cleanbot3000/Cleanbot3000/README.md

# Cleanbot3000
## This repository contains all documentation related to the Systems and Power sub teams.

## **Power**
The **Power** folder contains mechanical designs of the cleanbot, documentation for motors, motor drivers, power distribution, and [arduino](Power/Arduino).
