cleanbot3000/Cleanbot3000/Systems/ROS_Packages/diffdrive_arduino/README.md

# diffdrive_arduino

**Adds ROS2 Galactic and Humble support**

This node is designed to provide an interface between a `diff_drive_controller` from `ros_control` and an Arduino running firmware from `ros_arduino_bridge`.
