cleanbot3000/Cleanbot3000/Power/Cleanbot_Mech/CleanBot_Assembly/BLWRPG093S-R139.STEP

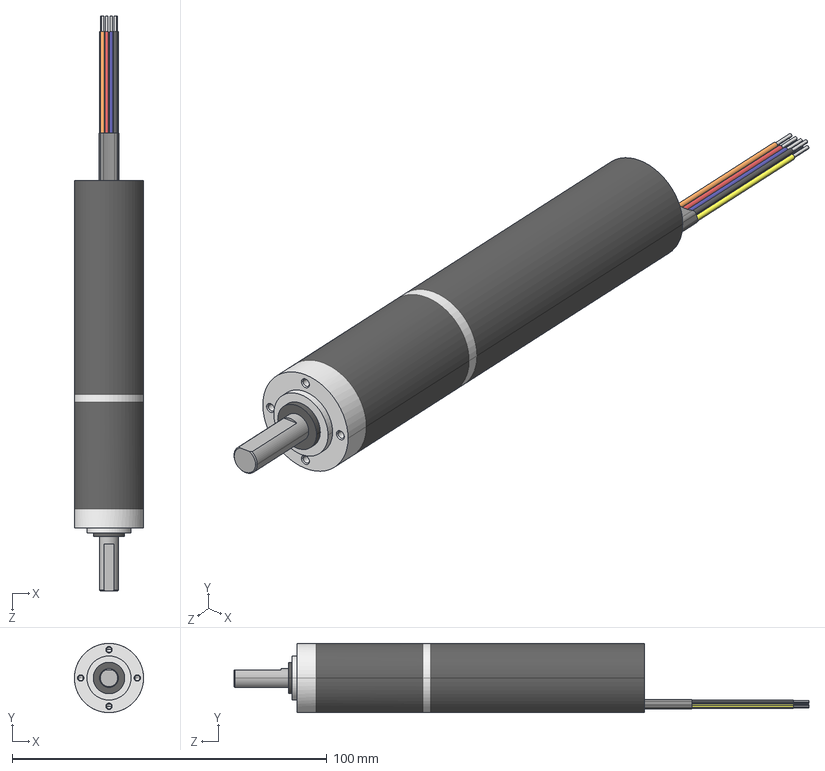
[picture p69: CAD file, 2023-09-08, last stored version]
Power/Cleanbot_Mech/CleanBot_Assembly/BLWRPG093S-R139.STEP
22.0 x 22.0 x 182.8 mm
