cleanbot3000/Cleanbot3000/Power/Cleanbot_Mech/CleanBot_Assembly/channel15.SLDPRT

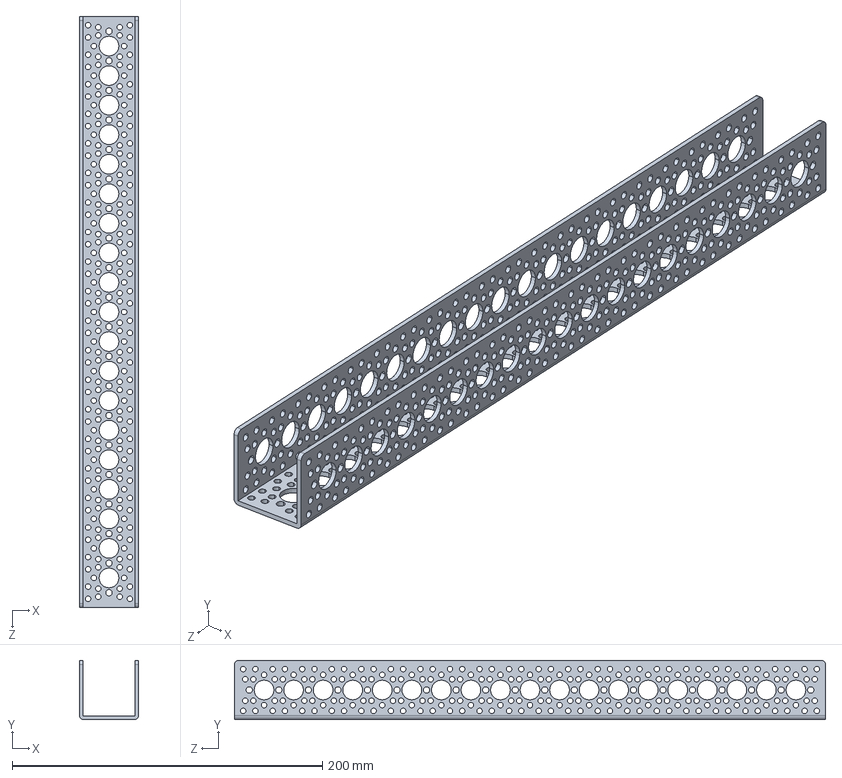
[picture p70: CAD file, 2023-09-08, last stored version]
Power/Cleanbot_Mech/CleanBot_Assembly/channel15.SLDPRT
38.1 x 38.1 x 381.0 mm
