cleanbot3000/Cleanbot3000/Power/Cleanbot_Mech/CleanBot_Assembly/LiDAR.SLDPRT

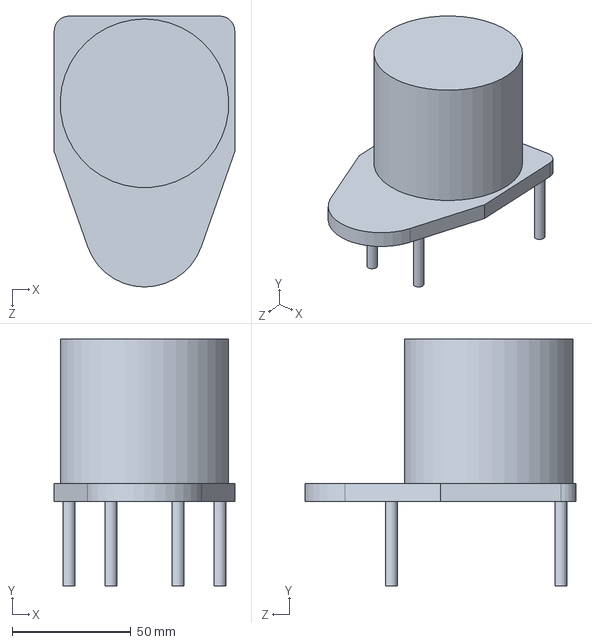
[picture p71: CAD file, 2023-09-08, last stored version]
Power/Cleanbot_Mech/CleanBot_Assembly/LiDAR.SLDPRT
76.2 x 104.1 x 114.3 mm
