cleanbot3000/Cleanbot3000/Power/Cleanbot_Mech/CleanBot_Assembly/HG-65GNB.STEP

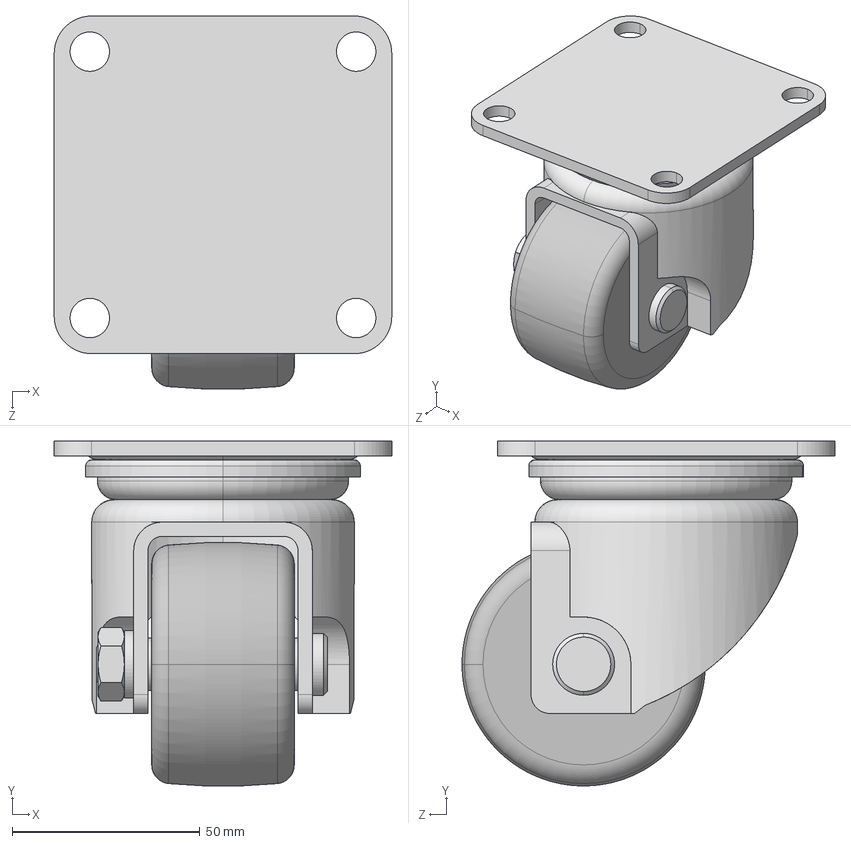
[picture p72: CAD file, 2023-09-08, last stored version]
Power/Cleanbot_Mech/CleanBot_Assembly/HG-65GNB.STEP
90.0 x 91.9 x 99.4 mm
