cleanbot3000/Cleanbot3000/Power/Cleanbot_Mech/CleanBot_Assembly/Chassis2(cover).SLDPRT

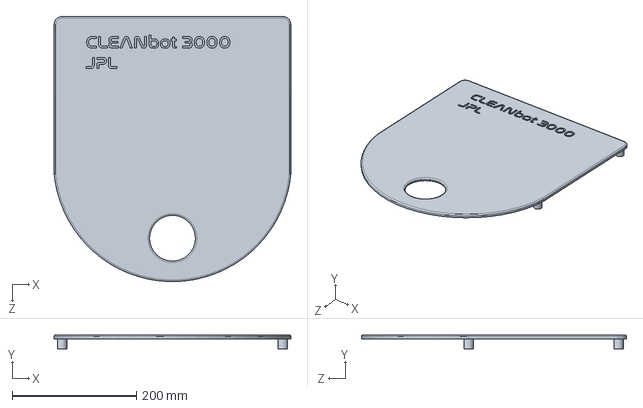
[picture p73: CAD file, 2023-09-08, last stored version]
Power/Cleanbot_Mech/CleanBot_Assembly/Chassis2(cover).SLDPRT
381.0 x 22.9 x 426.5 mm
