cleanbot3000/Cleanbot3000/Power/Cleanbot_Mech/CleanBot_Assembly/encoderHolder.SLDPRT

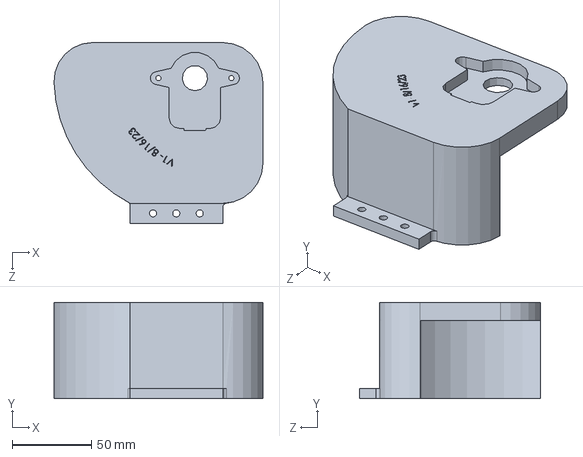
[picture p74: CAD file, 2023-09-08, last stored version]
Power/Cleanbot_Mech/CleanBot_Assembly/encoderHolder.SLDPRT
132.0 x 61.0 x 114.3 mm
