cleanbot3000/Cleanbot3000/Power/Cleanbot_Mech/CleanBot_Assembly/ENC-A5SX-XXXX-250-H-G.SLDPRT

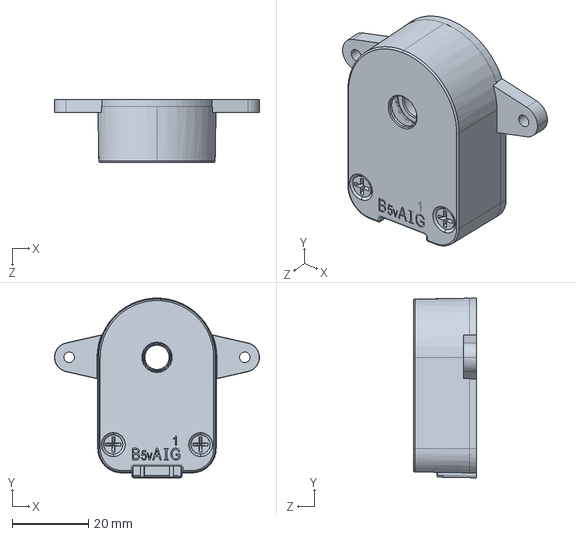
[picture p75: CAD file, 2023-09-08, last stored version]
Power/Cleanbot_Mech/CleanBot_Assembly/ENC-A5SX-XXXX-250-H-G.SLDPRT
53.7 x 47.1 x 16.6 mm
