cleanbot3000/Cleanbot3000/Power/Cleanbot_Mech/CleanBot_Assembly/Caster.SLDPRT

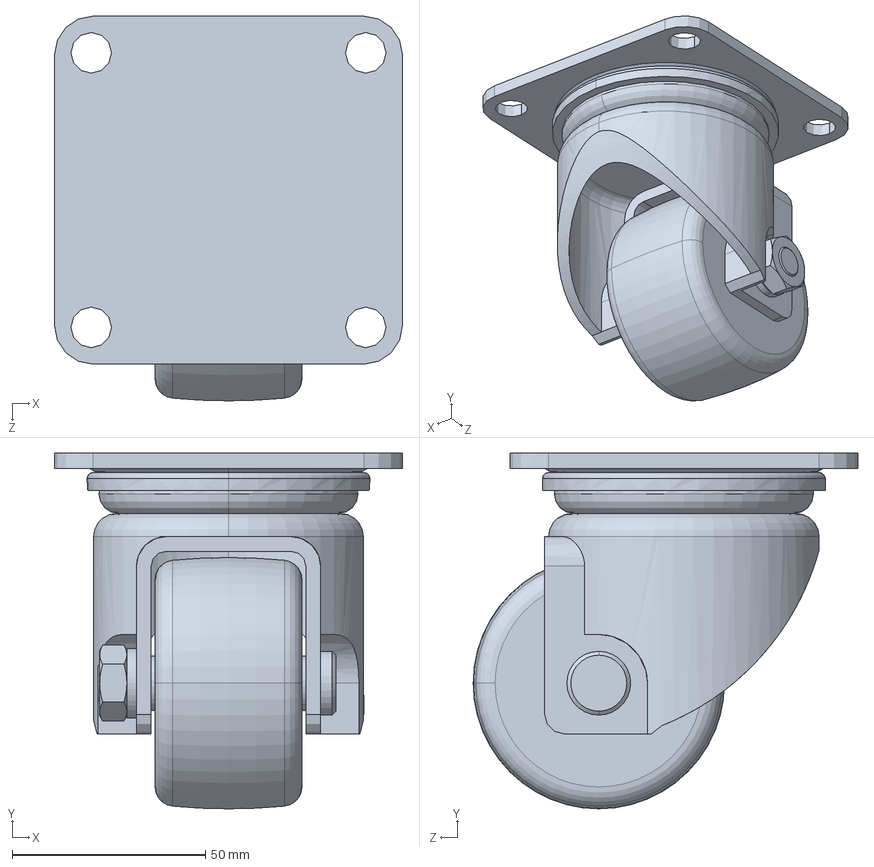
[picture p76: CAD file, 2023-09-08, last stored version]
Power/Cleanbot_Mech/CleanBot_Assembly/Caster.SLDPRT
90.0 x 92.0 x 99.5 mm
