cleanbot3000/Cleanbot3000/Power/Cleanbot_Mech/CleanBot_Assembly/ZyboB.SLDPRT

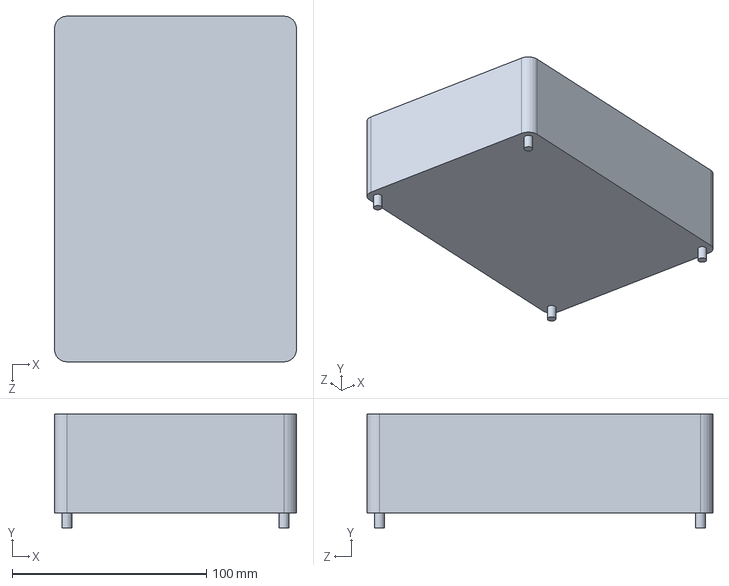
[picture p77: CAD file, 2023-09-08, last stored version]
Power/Cleanbot_Mech/CleanBot_Assembly/ZyboB.SLDPRT
124.5 x 58.4 x 177.8 mm
