cleanbot3000/Cleanbot3000/Power/Cleanbot_Mech/CleanBot_Assembly/Back wheels.SLDPRT

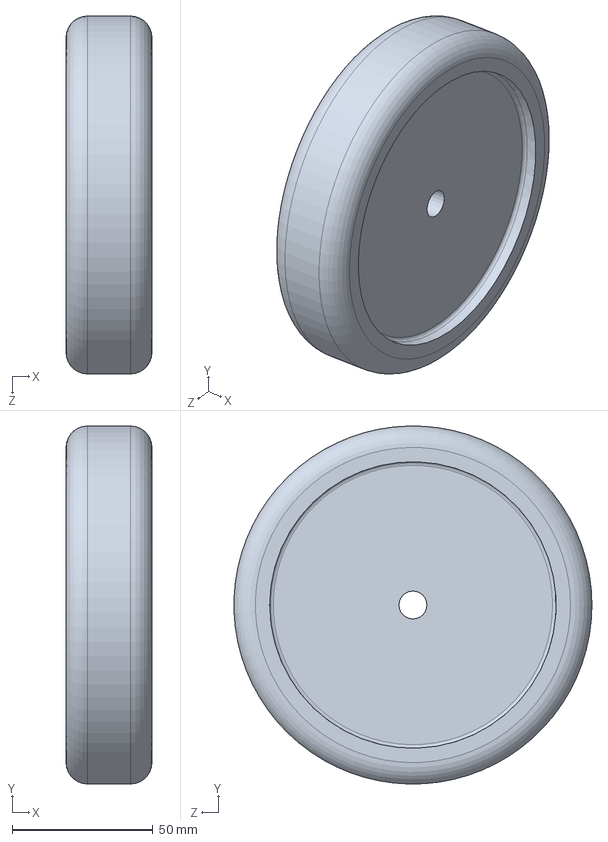
[picture p78: CAD file, 2023-09-08, last stored version]
Power/Cleanbot_Mech/CleanBot_Assembly/Back wheels.SLDPRT
30.5 x 127.0 x 126.9 mm
