cleanbot3000/Cleanbot3000/Power/Cleanbot_Mech/CleanBot_Assembly/Chassis2(level1).SLDPRT

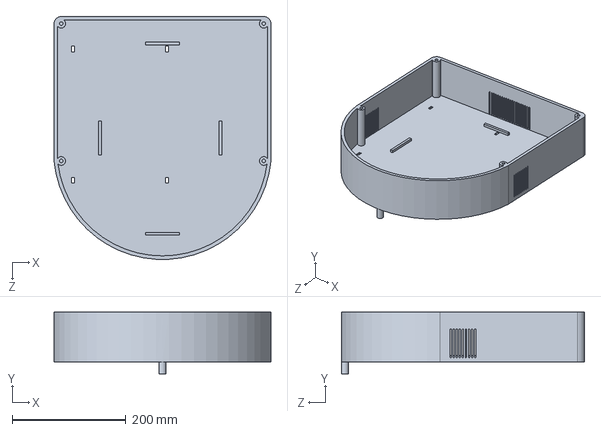
[picture p79: CAD file, 2023-09-08, last stored version]
Power/Cleanbot_Mech/CleanBot_Assembly/Chassis2(level1).SLDPRT
381.0 x 108.8 x 426.7 mm
