cleanbot3000/Cleanbot3000/Power/Cleanbot_Mech/CleanBot_Assembly/shaftextendr.SLDPRT

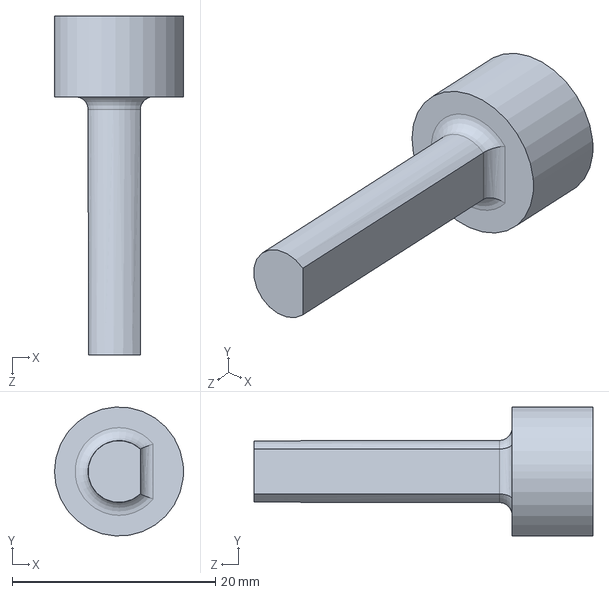
[picture p80: CAD file, 2023-09-08, last stored version]
Power/Cleanbot_Mech/CleanBot_Assembly/shaftextendr.SLDPRT
12.7 x 12.7 x 33.4 mm
