cleanbot3000/Cleanbot3000/Power/Cleanbot_Mech/CleanBot_Assembly/Chassis2(level2).SLDPRT

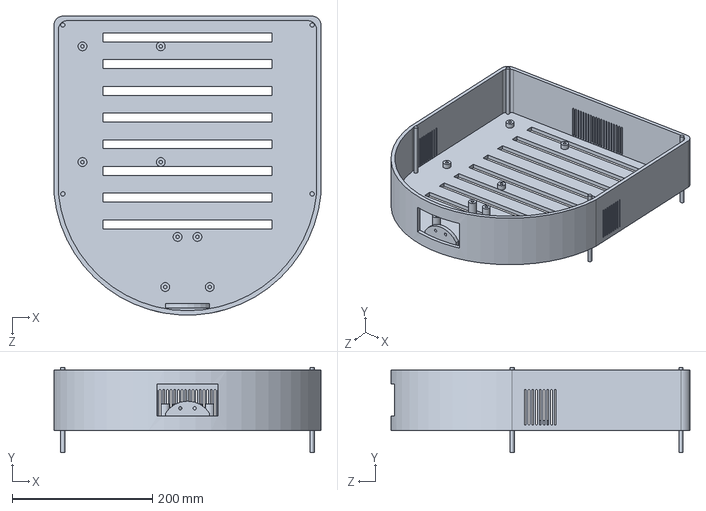
[picture p81: CAD file, 2023-09-08, last stored version]
Power/Cleanbot_Mech/CleanBot_Assembly/Chassis2(level2).SLDPRT
381.0 x 121.9 x 426.4 mm
