cleanbot3000/Cleanbot3000/Power/Cleanbot_Mech/CleanBot_Assembly/Sonar.SLDPRT

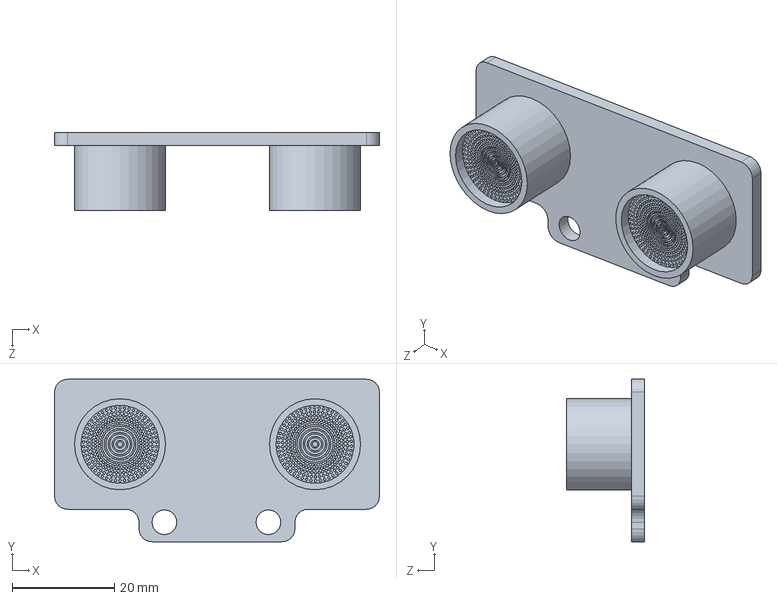
[picture p82: CAD file, 2023-09-08, last stored version]
Power/Cleanbot_Mech/CleanBot_Assembly/Sonar.SLDPRT
63.5 x 31.8 x 15.2 mm
