cleanbot3000/Cleanbot3000/Power/Cleanbot_Mech/CleanBot_Assembly/ENCH.SLDPRT

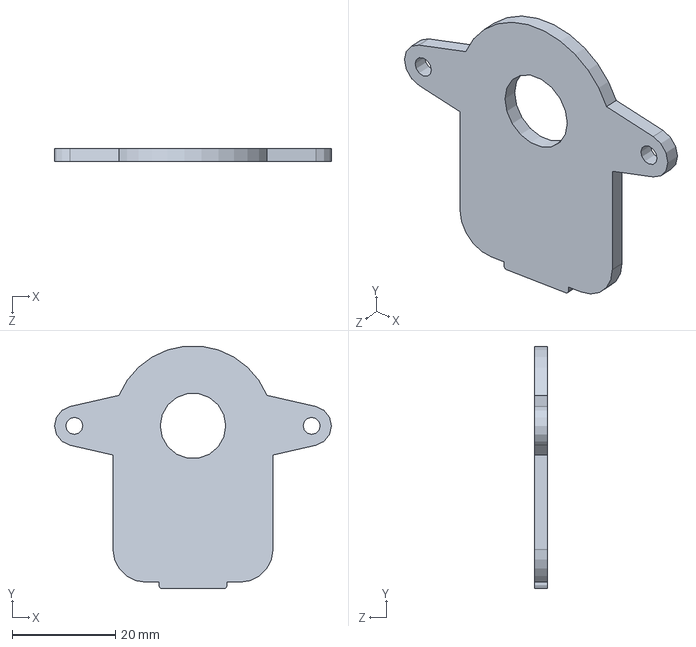
[picture p83: CAD file, 2023-09-08, last stored version]
Power/Cleanbot_Mech/CleanBot_Assembly/ENCH.SLDPRT
53.7 x 47.0 x 2.54 mm
