cleanbot3000/Cleanbot3000/(list of files, cad)

Other CAD files:
Power/Cleanbot_Mech/CleanBot_Assembly/MirrorencoderHolder.SLDPRT
