cleanbot3000/Cleanbot3000/(commit log)

2023-06-08 added ROS temperature package
2023-09-07 Added Solidworks Assembly
2023-09-08 Added CAD Files
    [BLWRPG093S-R139.STEP, Back wheels.SLDPRT, Caster.SLDPRT, Chassis2(cover).SLDPRT, Chassis2(level1).SLDPRT, Chassis2(level2).SLDPRT, ENC-A5SX-XXXX-250-H-G.SLDPRT, ENCH.SLDPRT]
2023-09-17 Documentation on motor and driver hookup
2023-09-24 added updated dimensions
    [BLWRPG093S-R139.STEP, Back wheels.SLDPRT, Caster.SLDPRT, Chassis2(cover).SLDPRT, Chassis2(level1).SLDPRT, Chassis2(level2).SLDPRT, ENC-A5SX-XXXX-250-H-G.SLDPRT, ENCH.SLDPRT]
2023-09-24 added rons power doc
2024-03-04 mikel/jpl_demo_2 potential submodule fix
    [robot_controller_example.yaml]
